blacksky008/Agricultural_IOT/ALL/其他/水肥一体机单片机采购清单.xlsx

采购清单
名称 | 数量 | 单位 | 设备参数 | 单个金额 | 采购金额 | 订单号 | 备注 | 能否开具发票 | 参考淘宝链接
arduino mega 2560 | 1 | 个
arduino W5100 | 1 | 个 |  |  |  |  |  |  | https://detail.tmall.com/item.htm?id=608340314398&ns=1&abbucket=11&skuId=4442123539861
隔离电源 | 1 | 个 | 功率：20W输出电压：5V输入电压：24V |  |  |  | 需裁剪 |  | https://item.taobao.com/item.htm?spm=a1z09.2.0.0.5af92e8dQBwOhz&id=4175918250&_u=i3lic3m7d3ea
485转ttl模块 | 1 | 个 |  |  |  |  |  |  | https://detail.tmall.com/item.htm?id=40702461378&spm=a1z09.2.0.0.5af92e8dQBwOhz&_u=i3lic3m76478
2pin端子 | 1 | 个 | CCM-5.08-2P |  |  |  |  |  | https://detail.tmall.com/item.htm?id=13301862191&spm=a1z09.2.0.0.5af92e8dQBwOhz&_u=i3lic3m7f249
3pin端子 | 1 | 个 | CCM-5.08-3P |  |  |  |  |  | https://detail.tmall.com/item.htm?id=13301862191&spm=a1z09.2.0.0.5af92e8dQBwOhz&_u=i3lic3m7f249
4pin端子 | 1 | 个 | CCM-5.08-4P |  |  |  |  |  | https://detail.tmall.com/item.htm?id=13301862191&spm=a1z09.2.0.0.5af92e8dQBwOhz&_u=i3lic3m7f249
尼龙螺柱 | 11 | 个
m3螺母 | 9 | 个
10pin端子 | 3 | 个 | XH2.54-LI-10P |  |  |  |  |  | https://detail.tmall.com/item.htm?id=13300685584&_u=i3lic3m79acf&skuId=3127349611518
7pin端子 | 2 | 个 | HDR2.54-M-LI-7P
1x8母排端子 | 2 | 个 | HDR2.54-M-LI-8P
1x6母排端子 | 1 | 个 | HDR2.54-M-LI-6P
1x10母排端子 | 1 | 个 | HDR2.54-M-LI-10P
2x3pin母排 | 1 | 个 | HDR2.54-M-LI-2x3P
2x3pin公排 | 1 | 个 | HDR2.54-LI-2x3P
1x8公排端子 | 5 | 个 | HDR2.54-LI-8P
1x10公排端子 | 1 | 个 | HDR2.54-LI-8P
18x2公排端子 | 1 | 个 | HDR2.54-LI-2x18P
XH 双头XH2.54MM 10pin | 2 | 条 |  |  |  |  | 双头 |  | https://detail.tmall.com/item.htm?id=35200807975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
8路继电器模块 | 1 | 个 | 5V XH2．54
