blacksky008/Agricultural_IOT/ALL/其他/水肥一体机采购清单.xlsx

采购清单
名称 | 数量 | 单位 | 设备参数 | 单个金额 | 采购金额 | 订单号 | 备注 | 能否开具发票 | 参考淘宝链接
常闭电磁阀 | 12 | 个 | 常闭型4分水阀DC24V（俗称DN15） |  |  |  | 15 |  | https://detail.tmall.com/item.htm?id=521713200472&spm=a1z09.2.0.0.6f462e8dZPecf3&_u=i3lic3m728e4
常开电磁阀 |  | 个 | 常开型4分水阀DC24V（俗称DN15） |  |  |  |  |  | https://detail.tmall.com/item.htm?id=521713200472&spm=a1z09.2.0.0.6f462e8dZPecf3&_u=i3lic3m728e4
压力变送器 | 3 | 个 | 2.5MPa0-5v，供电24v |  |  |  | 需要说明电压信号 |  | https://detail.tmall.com/item.htm?id=610566696702&_u=i3lic3m7e566&skuId=4297834816881
液位变送器 | 3 | 个 | 量程1m 24v 0-5v信号 | 150 |  |  | 可485，加价150 |  | https://item.taobao.com/item.htm?spm=a1z09.2.0.0.31bc2e8dC7A0Me&id=610919554436&_u=i3lic3m7f5ec
流量计 | 10 | 个 | 1.5寸 | 79 |  |  | 可购买13，需要和店家说明改装成24v的 |  | https://item.taobao.com/item.htm?spm=a1z09.2.0.0.31bc2e8dC7A0Me&id=40872347722&_u=i3lic3m77755
220V抽水泵 | 1 | 个 | 750W45米2.8吨220v | 615
搅拌机立式减速机 | 1 | 个 | 220V0.37KW带轴和桨叶 | 605
24v电源模块 | 3 | 个 | 24V16.5A400W
220V输入线 | 3 | 个 |  |  |  |  |  |  | https://detail.tmall.com/item.htm?id=602444103611&_u=i3lic3m75cdc&skuId=4383030194831
200L单坏（蓝色常规） | 3 | 个 |  |  |  |  |  |  | https://item.taobao.com/item.htm?spm=a1z09.2.0.0.31bc2e8dC7A0Me&id=39651971505&_u=i3lic3m71d42
ph | 1 | 个
ec | 1 | 个
24硅胶线红黑 | 200 | 米
4芯硅胶线 | 100 | 米
水晶头 | 100 | 个
六类网线 | 200 | 米
路由器 | 1 | 个
交换机 | 1 | 个
