blacksky008/Agricultural_IOT/ALL/其他/基于物联网水肥一体机系统开发/Source Code Until Jul 21/Source Code/ESP8266/Kejin_esp8266_test-master/README.md

esp8266\_test

项目目的
========

为之后的农业相关的项目做铺垫

项目基于arduino
esp8266，搭载led灯与光敏电阻分别对项目进行测试，主要测试的内容有：

1 如何在阿里云中部署物联网；

2 如何通过虚拟按钮控制执行器；

3 如何通过传感器读取外部数据并显示。

使用的库为AliyunIoTSDK，可以通过示例了解其运行方式。

接入网络
========

对于执行器需要回调函数去实现控制
