blacksky008/Agricultural_IOT/系统图-模型.pdf

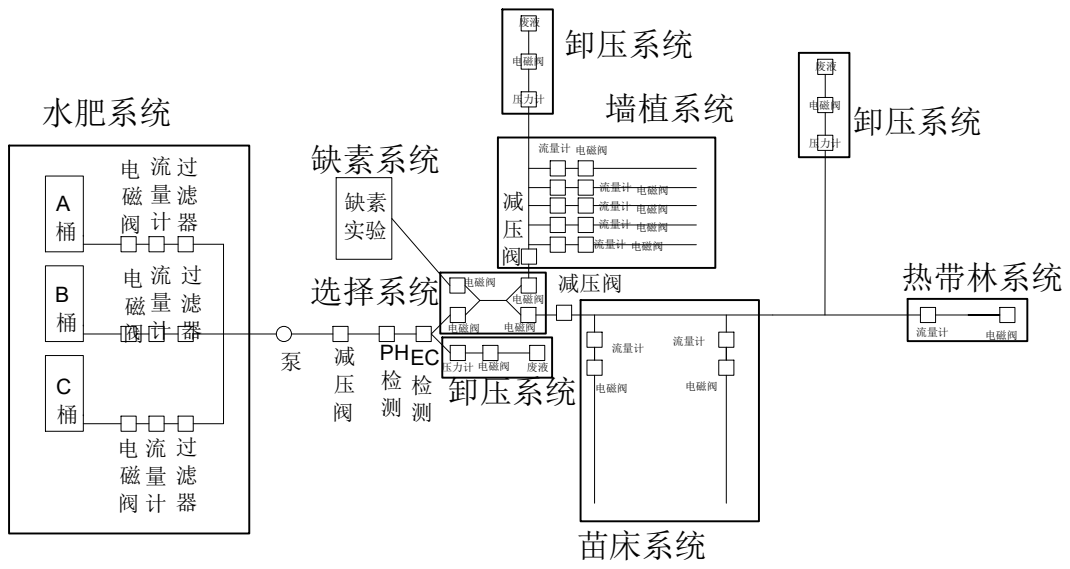
[picture p11: page 1]
电磁阀 流量计 过滤器 A桶; 电磁阀 流量计 过滤器 B桶C桶; 减压阀; PH检测 EC检测 水肥系统; 苗床系统; 热带林系统 卸压系统 缺素实验; 墙植系统 缺素系统 电磁阀 流量计 过滤器; 电磁阀; 电磁阀 电磁阀; 电磁阀废液 电磁阀 压力计 选择系统; 卸压系统 压力计 电磁阀; 废液 电磁阀 压力计; 卸压系统 减压阀; 减压阀 流量计 电磁阀流量计 电磁阀 流量计 电磁阀 流量计 电磁阀 流量计 电磁阀 电磁阀; 流量计; 电磁阀 流量计 流量计
