blacksky008/Agricultural_IOT/ALL/其他/基于物联网水肥一体机系统开发/Jul22-TH800传感器/Jul22-TH800传感器/温湿度变送器TH800说明书.pdf

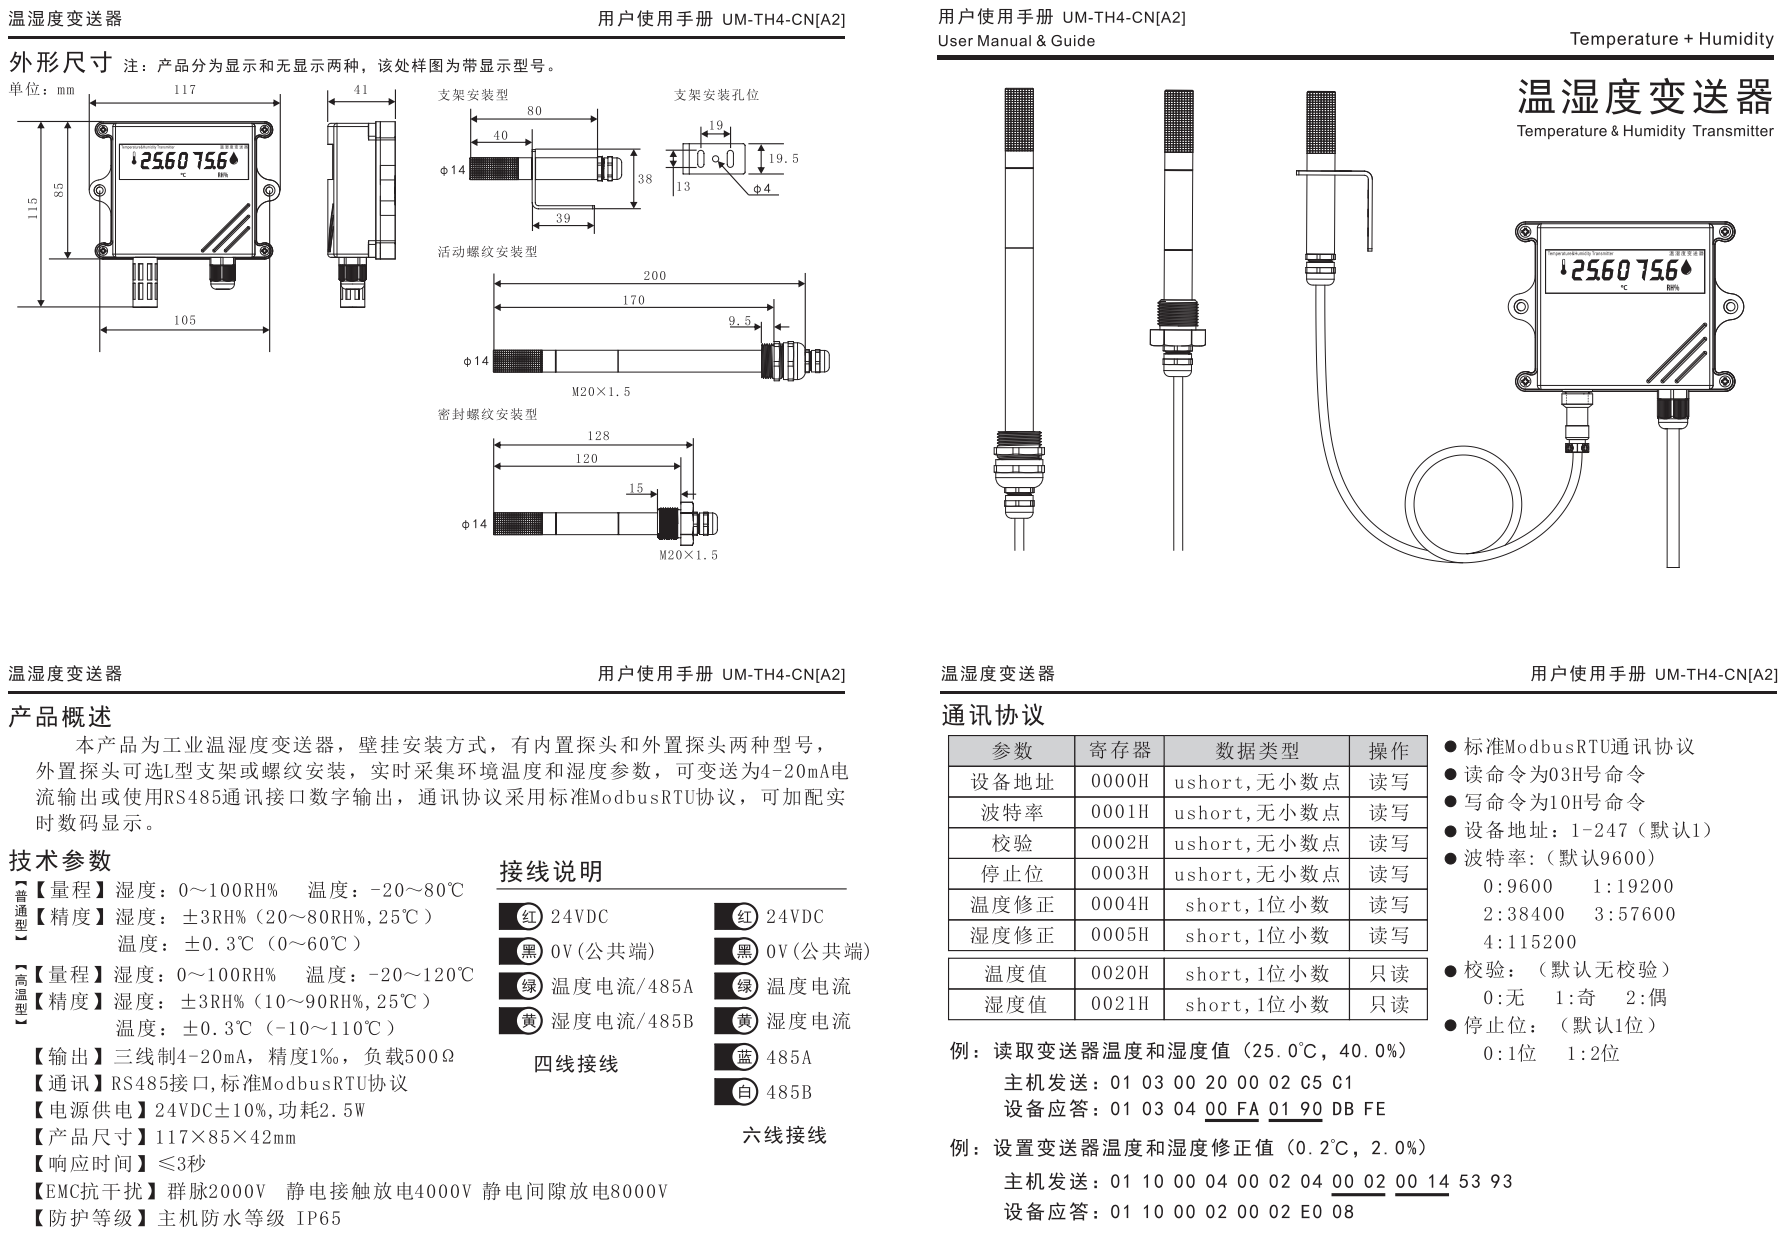
[picture p12: page 1]
