blacksky008/Agricultural_IOT/ALL/其他/基于物联网水肥一体机系统开发/Source Code Until Jul 21/Source Code/ESP8266/DHT11_read/DHT11_read.ino

#include <dhtnew.h> 


DHTNEW sensor1(1);

void setup()
{
  Serial.begin(9600);

}

void loop()
{
  Serial.println();

  

  Serial.print("Humidity (%): ");
  Serial.println((float)sensor1.getHumidity());

  Serial.print("Temperature (C): ");
  Serial.println((float)sensor1.getTemperature());

  delay(2000);

}
